OleksiiMykhailov1/teensy-synth-project/PCB files/teensy_4_1_pcb/new_synth_teensy4_1.kicad_pcb

## KiCad design PCB files/teensy_4_1_pcb/new_synth_teensy4_1.kicad_pcb (2026-10-25)

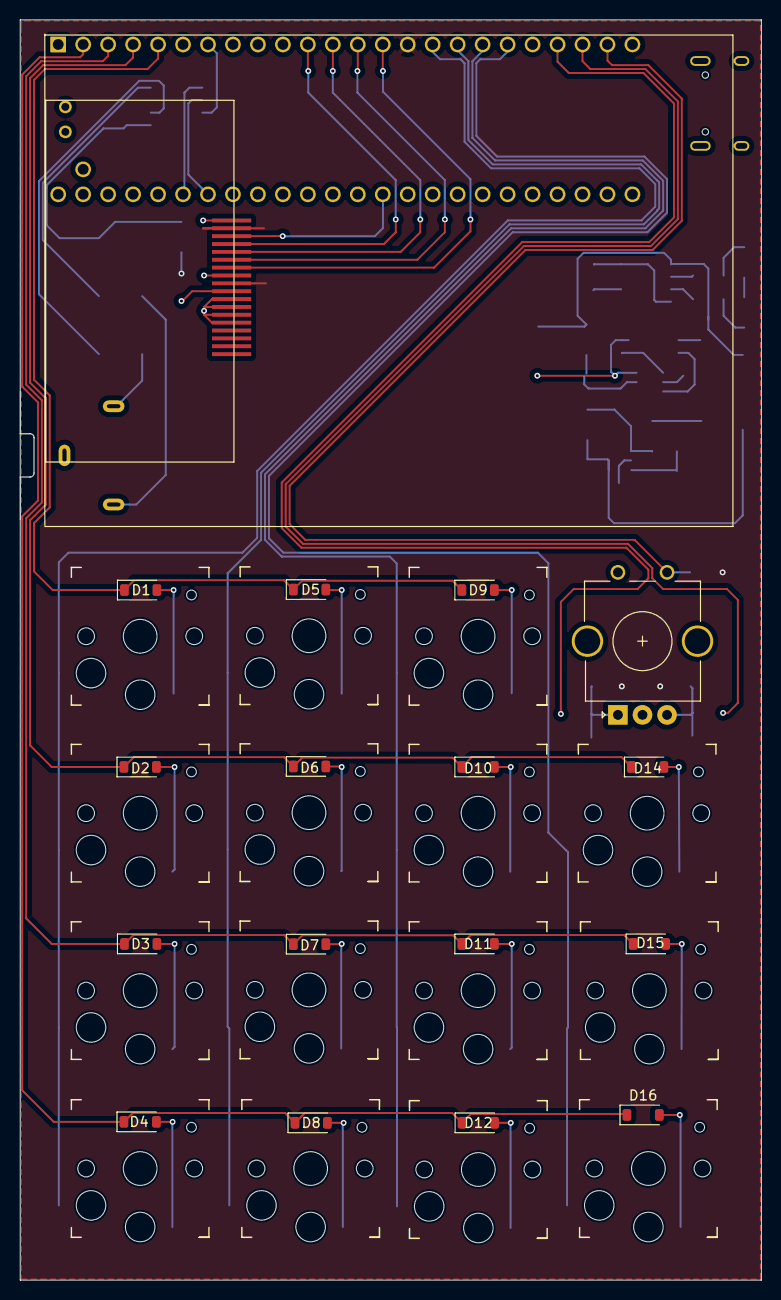
[picture p3: board new_synth_teensy4_1.kicad_pcb from above]

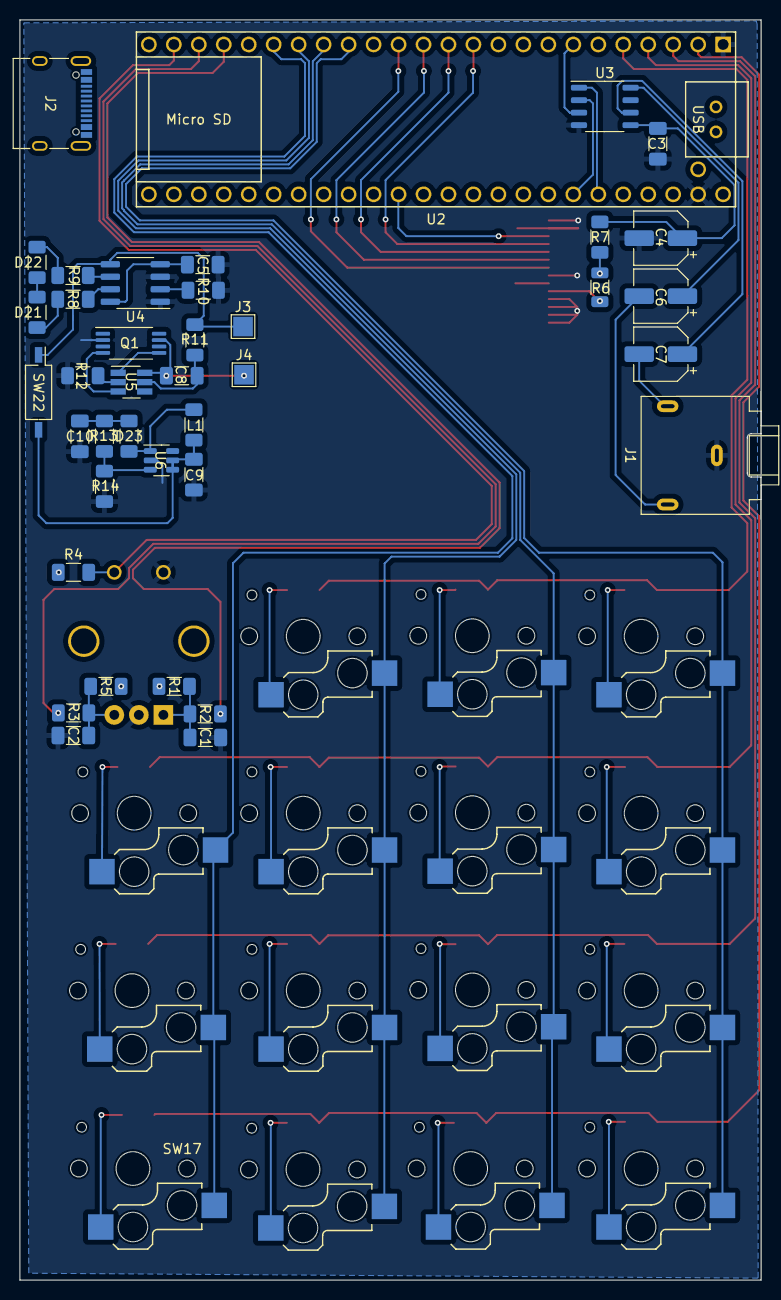
[picture p4: board new_synth_teensy4_1.kicad_pcb from below]

Board: 2 copper layers, 75.4 x 128.2 mm, 71 parts (39 on the bottom side), 61 nets.

Parts:
C1, C2: 100nF; C_1206_3216Metric_Pad1.33x1.80mm_HandSolder
C3: 0.1uF; C_1206_3216Metric_Pad1.33x1.80mm_HandSolder
C4, C6, C7: 47uF; CP_Elec_5x5.8
C5: 10uf; C_1206_3216Metric_Pad1.33x1.80mm_HandSolder
C8: 0.1uf; C_1206_3216Metric_Pad1.33x1.80mm_HandSolder
C9, C10: 22uf; C_1206_3216Metric_Pad1.33x1.80mm_HandSolder
D1, D2, D3, D4, D5, D6, D7, D8, D9, D10, D11, D12, D14, D15, D16: 1N4001; D_SOD-123
D21: RED; R_1206_3216Metric_Pad1.30x1.75mm_HandSolder
D22: GREEN; R_1206_3216Metric_Pad1.30x1.75mm_HandSolder
D23: D_Schottky; R_1206_3216Metric_Pad1.30x1.75mm_HandSolder
J1: AudioJack2_Ground; Jack_3.5mm_CUI_SJ1-3523N_Horizontal
J2: USB_B_Micro; USB_C_Receptacle_XKB_U262-16XN-4BVC11
J3: BAT+ Pad; TestPoint_Pad_2.0x2.0mm
J4: BAT- Pad; TestPoint_Pad_2.0x2.0mm
L1: 22UH; R_1206_3216Metric_Pad1.30x1.75mm_HandSolder
Q1: TSSOP-8_4.4x3mm_P0.65mm
R1, R2, R3, R4, R5: 10K; R_1206_3216Metric_Pad1.30x1.75mm_HandSolder
R6: 1k?; R_1206_3216Metric
R7: 10R; R_1206_3216Metric_Pad1.30x1.75mm_HandSolder
R8, R9: 1K; R_1206_3216Metric_Pad1.30x1.75mm_HandSolder
R10, R12: 2K; R_1206_3216Metric_Pad1.30x1.75mm_HandSolder
R11: r100; R_1206_3216Metric_Pad1.30x1.75mm_HandSolder
R13: 7.5k; R_1206_3216Metric_Pad1.30x1.75mm_HandSolder
R14: 1k; R_1206_3216Metric_Pad1.30x1.75mm_HandSolder
SW1: RotaryEncoder_Switch; RotaryEncoder_Alps_EC11E_Vertical_H20mm_CircularMountingHol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
SW2, SW3, SW4, SW5, SW6, SW7, SW8, SW9, SW10, SW11, SW12, SW13, SW15, SW16, SW17: SW_Push; Kailh_socket_PG1350
SW22: SW_DIP_x01; SW_DIP_SPSTx01_Slide_Copal_CHS-01B_W7.62mm_P1.27mm
U2: Teensy4.1; Teensy41
U3: SOP-8_3.9x4.9mm_P1.27mm
U4: TP4056; SOP-8_3.76x4.96mm_P1.27mm
U5: SOT-23-6_Handsoldering
U6: MT3608; SOT-23-6
U7: ILI9341_BARE_18PIN

Connections:
5V BAT: C10.2, D23.1 (K), R13.2
+3.3V: R1.2, R4.1, R5.1, R6.1, R7.2, U2.15 (3V3), U7.2 (Reset), U7.9 (VCC)
DIN: U2.7 (5_IN2), U3.3 (DIN)
GND: C1.2, C2.1, C3.2, C4.2, C5.2, C9.1, C10.1, J1.G, Q1.2 (S1), R10.1, R12.1, R14.1, SW1.C, SW1.S1, U2.1 (GND), U2.47 (GND), U3.4 (GND), U4.1 (Temp), U4.3 (GND), U6.2 (GND), U7.1 (GND), U7.8 (GND), U7.11 (K1(LED_Cathode)), U7.12 (K2(LED_Cathode)), U7.13 (K3(LED_Cathode)), U7.14 (K4(LED_Cathode))
unnamed: C1.1, R1.1, R2.2, SW1.A
unnamed: C2.2, R3.2, R5.2, SW1.B
unnamed: C6.2, J1.S
unnamed: C7.2, J1.T
unnamed: D1.2 (A), SW2.1
unnamed: D1.1 (K), D5.1 (K), D9.1 (K), U2.5 (3_LRCLK2)
unnamed: D2.2 (A), SW3.1
unnamed: D3.2 (A), SW4.1
unnamed: D4.2 (A), SW5.1
unnamed: D5.2 (A), SW6.1
unnamed: D6.2 (A), SW7.1
unnamed: D7.2 (A), SW8.1
unnamed: D8.2 (A), SW9.1
unnamed: D9.2 (A), SW10.1
unnamed: D10.2 (A), SW11.1
unnamed: D2.1 (K), D6.1 (K), D10.1 (K), D14.1 (K), U2.4 (2_OUT2)
unnamed: D11.2 (A), SW12.1
unnamed: D3.1 (K), D7.1 (K), D11.1 (K), D15.1 (K), U2.3 (1_TX1_CTX2_MISO1)
unnamed: D12.2 (A), SW13.1
unnamed: D4.1 (K), D8.1 (K), D12.1 (K), D16.1 (K), U2.2 (0_RX1_CRX2_CS1)
unnamed: D14.2 (A), SW15.1
unnamed: D15.2 (A), SW16.1
unnamed: D16.2 (A), SW17.1
unnamed: D21.2 (A), D22.2 (A)
unnamed: D21.1 (K), R8.2
unnamed: D22.1 (K), R9.2
unnamed: D23.2 (A), L1.2, U6.1 (SW)
unnamed: C5.1, U4.4 (VCC), U4.8 (CE)
unnamed: J3.1, R11.1, SW22.1, U4.5 (BAT)
unnamed: C8.1, J4.1, Q1.7 (S2), U5.6 (GND)
unnamed: Q1.4 (G1), U5.3 (OC)
unnamed: Q1.5 (G2), U5.1 (OD)
unnamed: U2.11 (9_OUT1C), U7.4 (DC/RS)
unnamed: U2.12 (10_CS_MQSR), U7.5 (CS)
unnamed: U2.13 (11_MOSI_CTX1), U7.6 (SDA(MOSI))
unnamed: U2.14 (12_MISO_MQSL), U7.7 (SDO(MISO))
unnamed: U2.42 (20_A6_TX5_LRCLK1), U3.2 (WS)
unnamed: U2.43 (21_A7_RX5_BCLK1), U3.1 (BCK)
unnamed: SW2.2, SW3.2, SW4.2, SW5.2, U2.16 (24_A10_TX6_SCL2)
unnamed: SW6.2, SW7.2, SW8.2, SW9.2, U2.17 (25_A11_RX6_SDA2)
unnamed: SW10.2, SW11.2, SW12.2, SW13.2, U2.18 (26_A12_MOSI1)
unnamed: SW15.2, SW16.2, SW17.2, U2.19 (27_A13_SCK1)
unnamed: R2.1, U2.21 (29_TX7)
unnamed: R3.1, U2.22 (30_CRX3)
unnamed: R4.2, SW1.S2, U2.23 (31_CTX3)
unnamed: C3.1, C4.1, R7.1, U3.5 (3.3)
unnamed: C7.1, U3.6 (LLCH)
unnamed: C6.1, U3.8 (RCH)
unnamed: R8.1, U4.7 (CHRG)
unnamed: R10.2, U4.2 (Prog)
unnamed: R9.1, U4.6 (STDBY)
unnamed: R12.2, U5.2 (CS)
unnamed: C8.2, R11.2, U5.5 (VCC)
unnamed: C9.2, L1.1, SW22.2, U6.4 (EN), U6.5 (IN)
unnamed: R13.1, R14.2, U6.3 (FB)
unnamed: R6.2, U7.10 (A(LED_Anode))
SCK: U2.35 (13_SCK_LED), U7.3 (SCL)
