OleksiiMykhailov1/teensy-synth-project/PCB files/teensy_3_6_pcb/synth_teensy.kicad_pcb

## KiCad design PCB files/teensy_3_6_pcb/synth_teensy.kicad_pcb (2026-10-25)

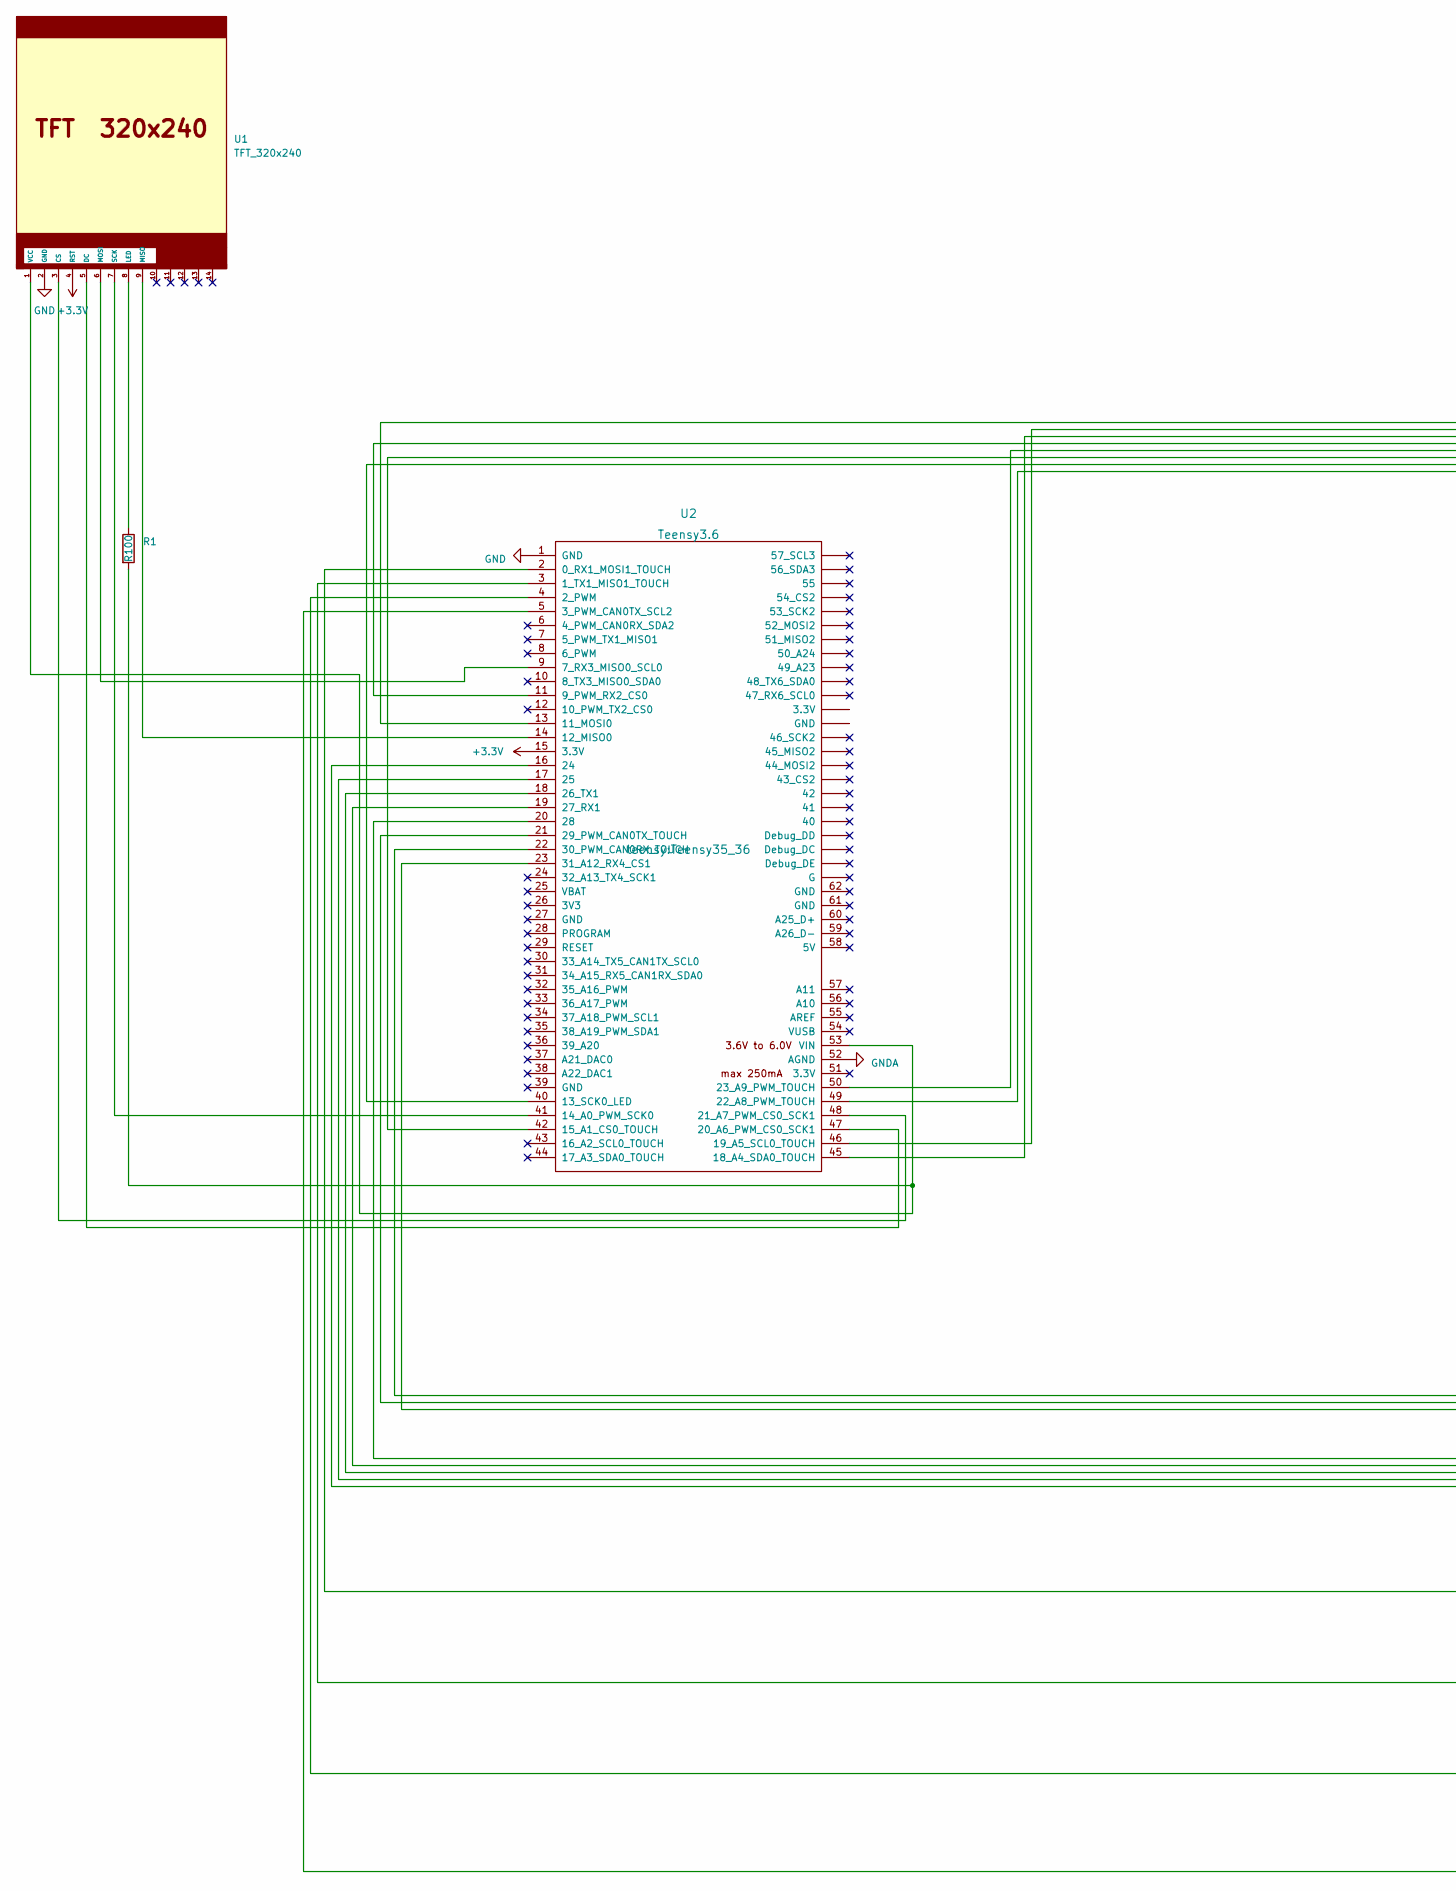
[picture p5: schematic synth_teensy.kicad_sch, part in row 1, column 1]

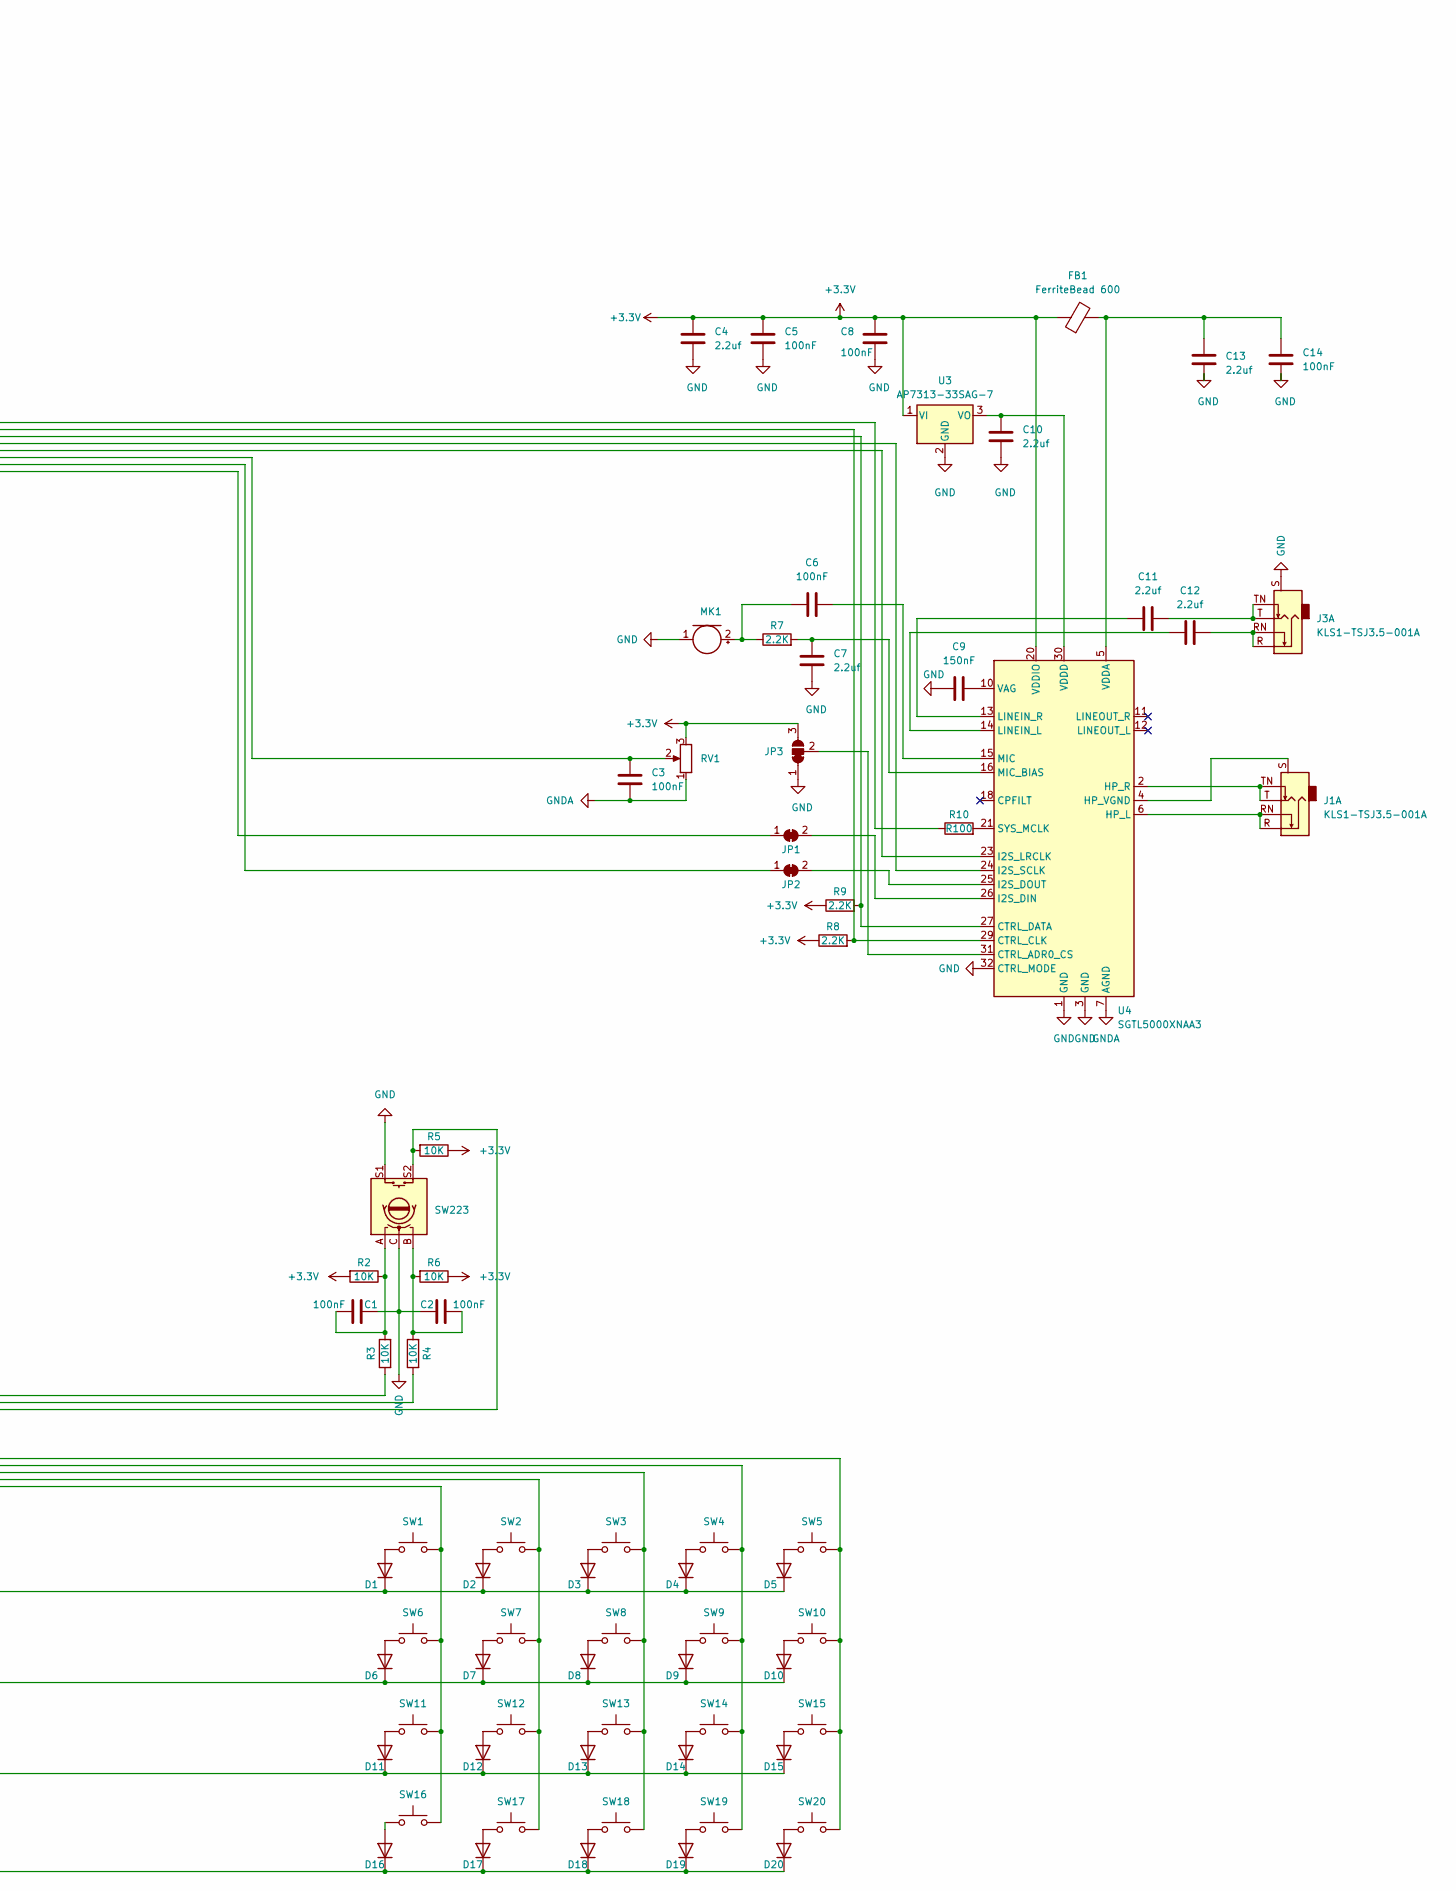
[picture p6: schematic synth_teensy.kicad_sch, part in row 1, column 2]

Parts:
C1, C2, C3, C5, C6, C8, C14: 100nF; C_1206_3216Metric_Pad1.33x1.80mm_HandSolder
C4, C7, C10, C11, C12, C13: 2.2uf; C_1206_3216Metric_Pad1.33x1.80mm_HandSolder
C9: 150nF; C_1206_3216Metric_Pad1.33x1.80mm_HandSolder
D1, D2, D3, D4, D5, D6, D7, D8, D9, D10, D11, D12, D13, D14, D15, D16, D17, D18, D19, D20: 1N4001; D_1210_3225Metric
FB1: FerriteBead 600; R_1206_3216Metric_Pad1.30x1.75mm_HandSolder
J1, J3: KLS1-TSJ3.5-001A; Jack_3.5mm_CUI_SJ1-3525N_Horizontal
JP1, JP2: SolderJumper_2_Bridged; SolderJumper-2_P1.3mm_Bridged_RoundedPad1.0x1.5mm
JP3: SolderJumper_3_Bridged12; SolderJumper-3_P1.3mm_Bridged12_RoundedPad1.0x1.5mm_NumberL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
MK1: Microphone; R_Axial_DIN0411_L9.9mm_D3.6mm_P12.70mm_Horizontal
R1, R10: R100; R_1206_3216Metric_Pad1.30x1.75mm_HandSolder
R2, R3, R4, R5, R6: 10K; R_1206_3216Metric_Pad1.30x1.75mm_HandSolder
R7, R8, R9: 2.2K; R_1206_3216Metric_Pad1.30x1.75mm_HandSolder
RV1: R_Potentiometer; Potentiometer_Alps_RK09Y11_Single_Horizontal
SW1, SW2, SW3, SW4, SW5, SW6, SW7, SW8, SW9, SW10, SW11, SW12, SW13, SW14, SW15, SW16, SW17, SW18, SW19, SW20: SW_Push; Kailh_socket_PG1350
SW223: RotaryEncoder_Switch; RotaryEncoder_Alps_EC11E_Vertical_H20mm_CircularMountingHol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
U1: TFT_320x240; TFT-320x240
U2: Teensy3.6; Teensy35_36
U3: AP7313-33SAG-7; SOT-23-3
U4: SGTL5000XNAA3; QFN-32-1EP_5x5mm_P0.5mm_EP3.6x3.6mm

Connections:
+3V3: C4.1, C5.1, C8.1, FB1.1, JP3.3 (B), R2.2, R5.1, R6.1, R8.1, R9.1, RV1.3, U1.4 (RST), U2.15 (3.3V), U3.1 (VI), U4.20 (VDDIO); also elsewhere on the board
GNDA: C3.2, RV1.1, U2.52 (AGND), U4.7 (AGND); also elsewhere on the board
unnamed: C1.1, R2.1, R3.2, SW223.A
unnamed: C2.2, R4.2, R6.2, SW223.B
unnamed: C11.2, J3.T, J3.TN
unnamed: C12.2, J3.R, J3.RN
unnamed: D1.2 (A), SW1.1
unnamed: D1.1 (K), D2.1 (K), D3.1 (K), D4.1 (K), D5.1 (K), U2.2 (0_RX1_MOSI1_TOUCH)
unnamed: D2.2 (A), SW2.1
unnamed: D3.2 (A), SW3.1
unnamed: D4.2 (A), SW4.1
unnamed: D5.2 (A), SW5.1
unnamed: D6.2 (A), SW6.1
unnamed: D7.2 (A), SW7.1
unnamed: D8.2 (A), SW8.1
unnamed: D9.2 (A), SW9.1
unnamed: D10.2 (A), SW10.1
unnamed: D6.1 (K), D7.1 (K), D8.1 (K), D9.1 (K), D10.1 (K), U2.3 (1_TX1_MISO1_TOUCH)
unnamed: D11.2 (A), SW11.1
unnamed: D11.1 (K), D12.1 (K), D13.1 (K), D14.1 (K), D15.1 (K), U2.4 (2_PWM)
unnamed: D12.2 (A), SW12.1
unnamed: D13.2 (A), SW13.1
unnamed: D14.2 (A), SW14.1
unnamed: D15.2 (A), SW15.1
unnamed: D16.2 (A), SW16.1
unnamed: D16.1 (K), D17.1 (K), D18.1 (K), D19.1 (K), D20.1 (K), U2.5 (3_PWM_CAN0TX_SCL2)
unnamed: D17.2 (A), SW17.1
unnamed: D18.2 (A), SW18.1
unnamed: D19.2 (A), SW19.1
unnamed: D20.2 (A), SW20.1
unnamed: JP1.1 (A), U2.49 (22_A8_PWM_TOUCH)
unnamed: JP1.2 (B), U4.26 (I2S_DIN)
unnamed: JP2.1 (A), U2.40 (13_SCK0_LED)
unnamed: JP2.2 (B), U4.25 (I2S_DOUT)
unnamed: JP3.2 (C), U4.31 (CTRL_ADR0_CS)
unnamed: C6.1, MK1.2 (+), R7.1
unnamed: U1.3 (CS), U2.48 (21_A7_PWM_CS0_SCK1)
unnamed: U1.5 (DC), U2.47 (20_A6_PWM_CS0_SCK1)
unnamed: R1.1, U1.8 (LED)
unnamed: U1.9 (MISO), U2.14 (12_MISO0)
unnamed: U1.6 (MOSI), U2.9 (7_RX3_MISO0_SCL0)
unnamed: U1.7 (SCK), U2.41 (14_A0_PWM_SCK0)
unnamed: R1.2, U1.1 (VCC), U2.53 (VIN)
unnamed: U2.11 (9_PWM_RX2_CS0), U4.24 (I2S_SCLK)
unnamed: R10.1, U2.13 (11_MOSI0)
unnamed 45: C3.1, RV1.2, U2.42 (15_A1_CS0_TOUCH); also elsewhere on the board
unnamed: R9.2, U2.45 (18_A4_SDA0_TOUCH), U4.27 (CTRL_DATA)
unnamed: R8.2, U2.46 (19_A5_SCL0_TOUCH), U4.29 (CTRL_CLK)
unnamed: U2.50 (23_A9_PWM_TOUCH), U4.23 (I2S_LRCLK)
unnamed: SW1.2, SW6.2, SW11.2, SW16.2, U2.16 (24)
unnamed: SW2.2, SW7.2, SW12.2, SW17.2, U2.17 (25)
unnamed: SW3.2, SW8.2, SW13.2, SW18.2, U2.18 (26_TX1)
unnamed: SW4.2, SW9.2, SW14.2, SW19.2, U2.19 (27_RX1)
unnamed: SW5.2, SW10.2, SW15.2, SW20.2, U2.20 (28)
unnamed: R4.1, U2.21 (29_PWM_CAN0TX_TOUCH)
unnamed: R3.1, U2.22 (30_PWM_CAN0RX_TOUCH)
unnamed: R5.2, SW223.S2, U2.23 (31_A12_RX4_CS1)
unnamed: J1.R, J1.RN, U4.6 (HP_L)
unnamed: J1.T, J1.TN, U4.2 (HP_R)
unnamed: J1.S, U4.4 (HP_VGND)
unnamed: C12.1, U4.14 (LINEIN_L)
unnamed: C11.1, U4.13 (LINEIN_R)
unnamed: C6.2, U4.15 (MIC)
unnamed: C7.2, R7.2, U4.16 (MIC_BIAS)
unnamed: R10.2, U4.21 (SYS_MCLK)
unnamed: C9.2, U4.10 (VAG)
unnamed: C13.1, C14.1, FB1.2, U4.5 (VDDA)

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
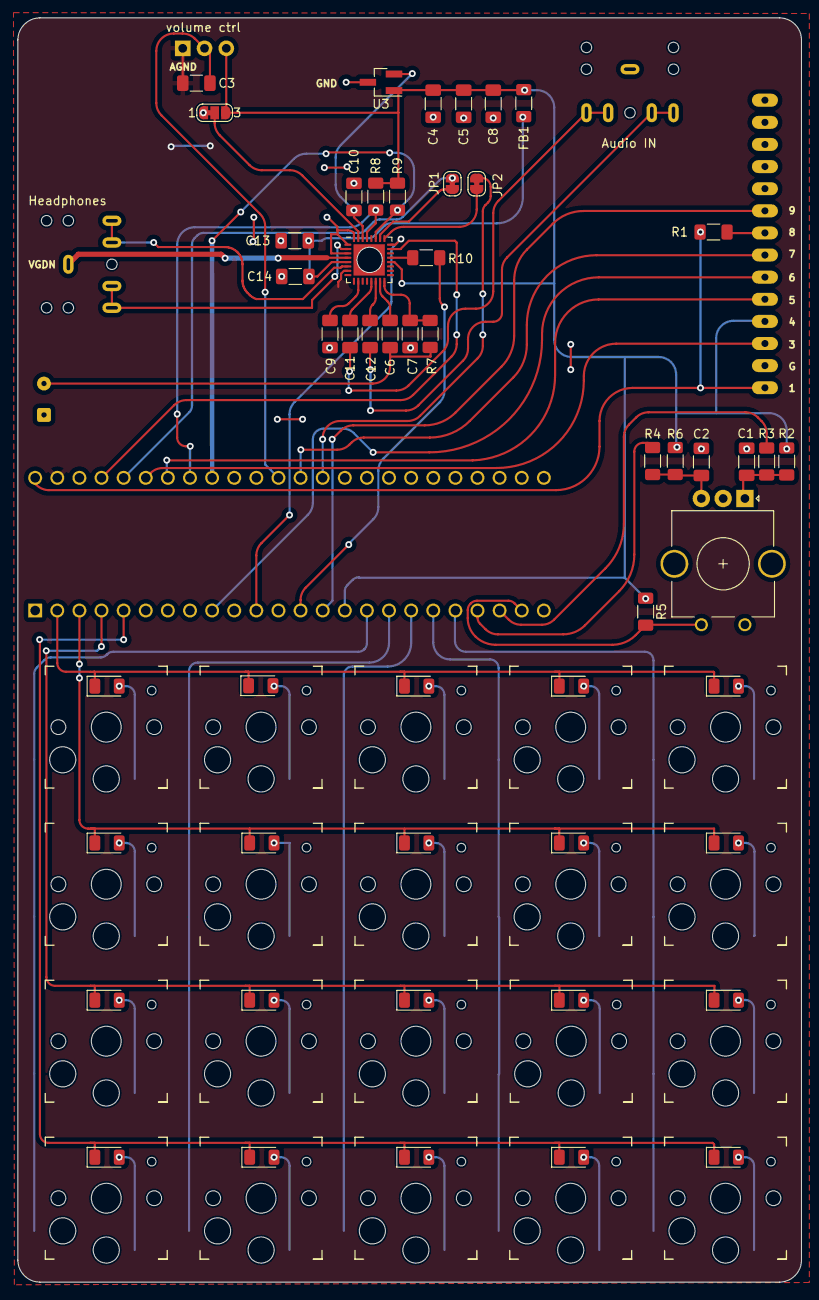
[picture p7: board synth_teensy.kicad_pcb from above]

Board: 2 copper layers, 90.0 x 145.2 mm, 77 parts (0 on the bottom side), 69 nets.

Other parts of the board:
volume ctrl: R_Potentiometer; Potentiometer_Alps_RK09Y11_Single_Horizontal

Their connections:
+3V3: volume ctrl.3; also elsewhere on the board
GNDA: volume ctrl.1; also elsewhere on the board
unnamed 45: volume ctrl.2; also elsewhere on the board
