OleksiiMykhailov1/teensy-synth-project/Firmware files/src/algo_bitmap.h

// 'algorithm1', 34x83px
const unsigned char fm_algorithm1 [] PROGMEM = {
	0x00, 0x1f, 0x00, 0x00, 0x00, 0x00, 0x60, 0xc0, 0x00, 0x00, 0x00, 0x80, 0x20, 0x00, 0x00, 0x01, 
	0x00, 0x10, 0x00, 0x00, 0x02, 0x00, 0x08, 0x00, 0x00, 0x02, 0x04, 0x08, 0x00, 0x00, 0x04, 0x0c, 
	0x04, 0x00, 0x00, 0x04, 0x14, 0x04, 0x00, 0x00, 0x04, 0x04, 0x04, 0x00, 0x00, 0x04, 0x04, 0x04, 
	0x00, 0x00, 0x04, 0x04, 0x04, 0x00, 0x00, 0x02, 0x04, 0x08, 0x00, 0x00, 0x02, 0x00, 0x08, 0x00, 
	0x00, 0x01, 0x00, 0x10, 0x00, 0x00, 0x00, 0x80, 0x20, 0x00, 0x00, 0x00, 0x60, 0xc0, 0x00, 0x00, 
	0x00, 0x1f, 0x00, 0x00, 0x00, 0x00, 0x04, 0x00, 0x00, 0x00, 0x00, 0x04, 0x00, 0x00, 0x00, 0x00, 
	0x04, 0x00, 0x00, 0x00, 0x00, 0x04, 0x00, 0x00, 0x00, 0x00, 0x04, 0x00, 0x00, 0x00, 0x00, 0x1f, 
	0x00, 0x00, 0x00, 0x00, 0x60, 0xc0, 0x00, 0x00, 0x00, 0x80, 0x20, 0x00, 0x00, 0x01, 0x00, 0x10, 
	0x00, 0x00, 0x02, 0x00, 0x08, 0x00, 0x00, 0x02, 0x0e, 0x08, 0x00, 0x00, 0x04, 0x11, 0x04, 0x00, 
	0x00, 0x04, 0x01, 0x04, 0x00, 0x00, 0x04, 0x02, 0x04, 0x00, 0x00, 0x04, 0x04, 0x04, 0x00, 0x00, 
	0x04, 0x08, 0x04, 0x00, 0x00, 0x02, 0x1f, 0x08, 0x00, 0x00, 0x02, 0x00, 0x08, 0x00, 0x00, 0x01, 
	0x00, 0x10, 0x00, 0x00, 0x00, 0x80, 0x20, 0x00, 0x00, 0x00, 0x60, 0xc0, 0x00, 0x00, 0x00, 0x1f, 
	0x00, 0x00, 0x00, 0x00, 0x04, 0x00, 0x00, 0x00, 0x00, 0x04, 0x00, 0x00, 0x00, 0x00, 0x04, 0x00, 
	0x00, 0x00, 0x00, 0x04, 0x00, 0x00, 0x00, 0x00, 0x04, 0x00, 0x00, 0x00, 0x00, 0x1f, 0x00, 0x00, 
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
const int fm_allArray_LEN = 11;
const unsigned char* fm_allArray[11] = {
	fm_algorithm1,
	fm_algorithm2,
	fm_algorithm3,
	fm_algorithm4,
	fm_algorithm5,
	fm_algorithm6,
	fm_algorithm7,
	fm_algorithm8,
	fm_algorithm9,
	fm_algorithm10,
	fm_algorithm11
};


// '1', 29x8px
const unsigned char wf_1 [] PROGMEM = {
	0x07, 0xf0, 0x7f, 0x00, 0x04, 0x10, 0x41, 0x00, 0x04, 0x10, 0x41, 0x00, 0x04, 0x10, 0x41, 0x00, 
	0x04, 0x10, 0x41, 0x00, 0x04, 0x10, 0x41, 0x00, 0x04, 0x10, 0x41, 0x00, 0xfc, 0x1f, 0xc1, 0xf8
};

// '2', 29x8px
const unsigned char wf_2 [] PROGMEM = {
	0x03, 0x80, 0x0e, 0x00, 0x04, 0x40, 0x11, 0x00, 0x08, 0x20, 0x20, 0x80, 0x08, 0x20, 0x20, 0x80, 
	0x10, 0x10, 0x40, 0x40, 0x10, 0x10, 0x40, 0x40, 0x20, 0x08, 0x80, 0x20, 0xc0, 0x07, 0x00, 0x18
};

// '3', 29x8px
const unsigned char wf_3 [] PROGMEM = {
	0x01, 0x00, 0x04, 0x00, 0x02, 0x80, 0x0a, 0x00, 0x04, 0x40, 0x11, 0x00, 0x08, 0x20, 0x20, 0x80, 
	0x10, 0x10, 0x40, 0x40, 0x20, 0x08, 0x80, 0x20, 0x40, 0x05, 0x00, 0x10, 0x80, 0x02, 0x00, 0x08
};

// Array of all bitmaps for convenience. (Total bytes used to store images in PROGMEM = 144)
const int wf_allArray_LEN = 3;
const unsigned char* wf_allArray[3] = {
	wf_2,
	wf_3,
	wf_1
	
};
