OleksiiMykhailov1/teensy-synth-project/Firmware files/src/algorithms.h

#include <audiopatching.h>
void algorithm_1() {
op1_input_mix.gain(0,0.0);
op1_input_mix.gain(1,0.0);
op1_input_mix.gain(2,0.0);
op1_input_mix.gain(3,0.0);

op2_input_mix.gain(0,0.5);
op2_input_mix.gain(1,0.0);
op2_input_mix.gain(2,0.0);
op2_input_mix.gain(3,0.0);

op3_input_mix.gain(0,0.0);
op3_input_mix.gain(1,0.5);
op3_input_mix.gain(2,0.0);
op3_input_mix.gain(3,0.0);

op4_input_mix.gain(0, 0.0);
op4_input_mix.gain(1, 0.0);
op4_input_mix.gain(2, 1.0);
op4_input_mix.gain(3, 0.0);

voice1_mixer.gain(0, 0.0);
voice1_mixer.gain(1, 0.0);
voice1_mixer.gain(2, 0.0);
voice1_mixer.gain(3, 0.5);


op1_input_mix_1.gain(0,0.0);
op1_input_mix_1.gain(1,0.0);
op1_input_mix_1.gain(2,0.0);
op1_input_mix_1.gain(3,0.0);

op2_input_mix_1.gain(0,0.5);
op2_input_mix_1.gain(1,0.0);
op2_input_mix_1.gain(2,0.0);
op2_input_mix_1.gain(3,0.0);

op3_input_mix_1.gain(0,0.0);
op3_input_mix_1.gain(1,0.5);
op3_input_mix_1.gain(2,0.0);
op3_input_mix_1.gain(3,0.0);

op4_input_mix_1.gain(0, 0.0);
op4_input_mix_1.gain(1, 0.0);
op4_input_mix_1.gain(2, 1.0);
op4_input_mix_1.gain(3, 0.0);

voice2_mixer.gain(0, 0.0);
voice2_mixer.gain(1, 0.0);
voice2_mixer.gain(2, 0.0);
voice2_mixer.gain(3, 0.5);

op1_input_mix_2.gain(0,0.0);
op1_input_mix_2.gain(1,0.0);
op1_input_mix_2.gain(2,0.0);
op1_input_mix_2.gain(3,0.0);

op2_input_mix_2.gain(0,0.5);
op2_input_mix_2.gain(1,0.0);
op2_input_mix_2.gain(2,0.0);
op2_input_mix_2.gain(3,0.0);

op3_input_mix_2.gain(0,0.0);
op3_input_mix_2.gain(1,0.5);
op3_input_mix_2.gain(2,0.0);
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

    case 5:
algorithm_5();
    break;

    case 6:
algorithm_6();
    break;

    case 7:
algorithm_7();
    break;

    case 8:
algorithm_8();
    break;

    case 9:
algorithm_9();
    break;

    case 10:
algorithm_10();
    break;
    
        case 11:
algorithm_11();
    break;
}    
}
